PhuocCEA/Smart-Home-Embedded-Real-Time-System/Report_Slide/Project Embedded System Sem 2 25-26 (1).docx

Project Embedded System Sem 2 (2025-2026)

1. Autonomous Vehicle with Two Modes: Self-Driving and Manual Control
2. Automated Goods Classification System
3. Handheld Gaming Console
4. A Smart Home Project with Multiple Functionalities
5. Smart Parking System
6. Autonomous Line-Following and Obstacle-Avoidance Robot
7. Fingerprint-Based Attendance System
8. Smart Garden System
9. An Intelligent Firefighting System
10. Smart Vacuum Cleaner
11. Two-Wheeled Self-Balancing Vehicle
