PhuocCEA/Smart-Home-Embedded-Real-Time-System/Result/PIC_Custom_Relay (1).pdf

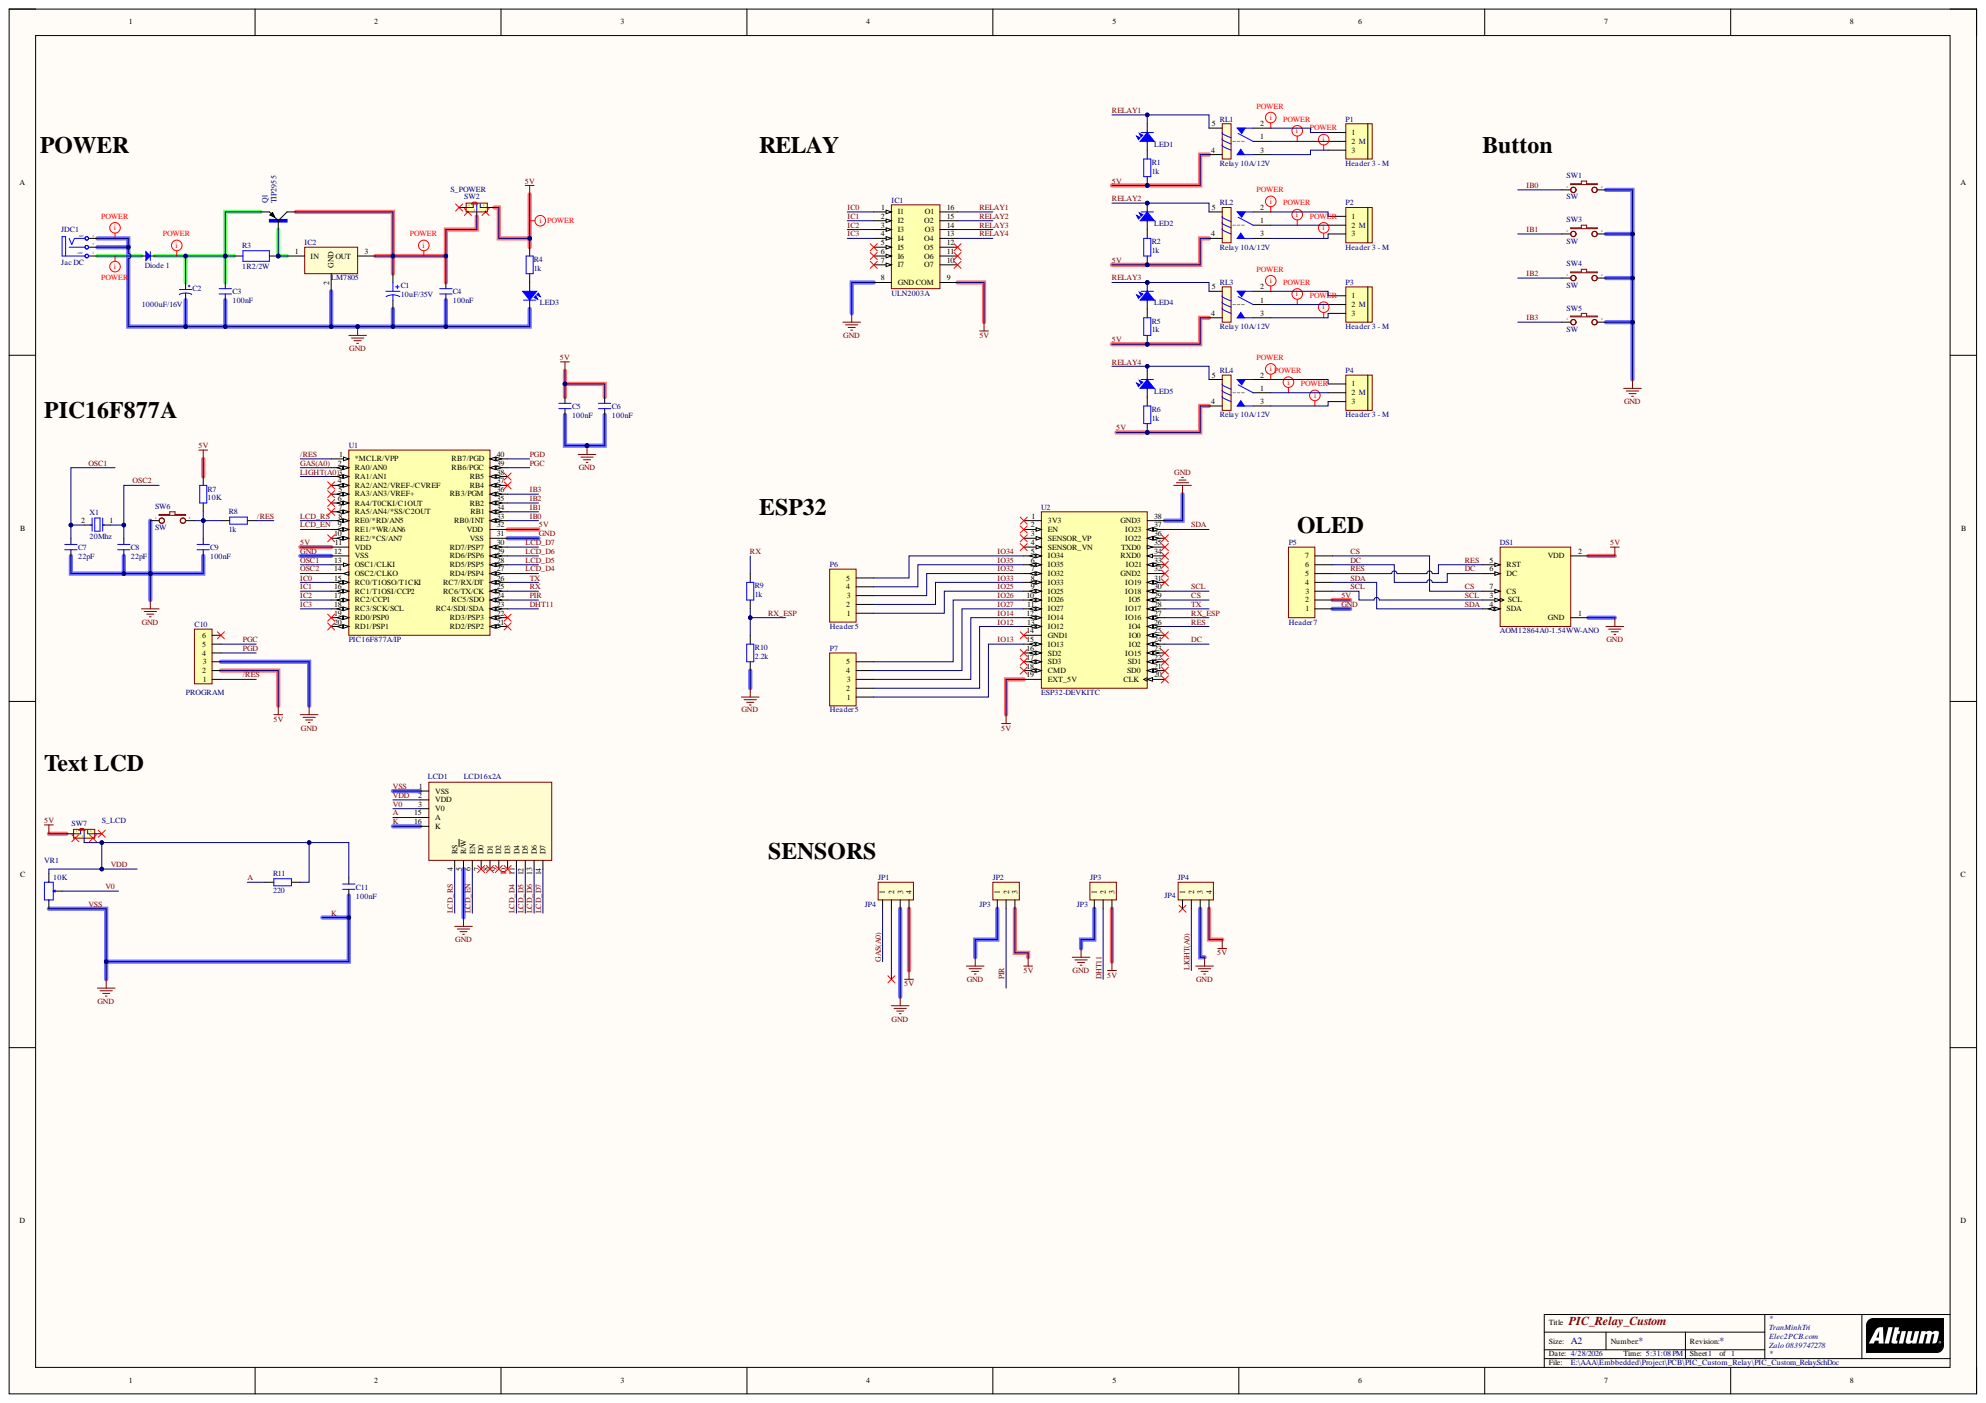
[picture p8: page 1]

12 i P O WER i 3 | 1He 123 M
