PhuocCEA/Smart-Home-Embedded-Real-Time-System/(list of files, drawings)

Other design files:
PCB_Project/PCB_Project/PCB_Project.PrjPcb
PCB_Project/PCB_Project/USB_RS485_Board.SchDoc
PCB_Project/PCB_Project/USB_RS485_UART.PcbDoc
